echener/velotracker/PU_Website/Bilder/Aaron.PNG

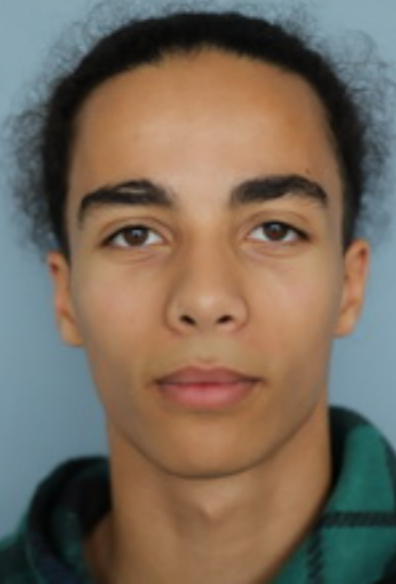
PU_Website/Bilder/Aaron.PNG
