echener/velotracker/PU_Website/Bilder/Francois.PNG

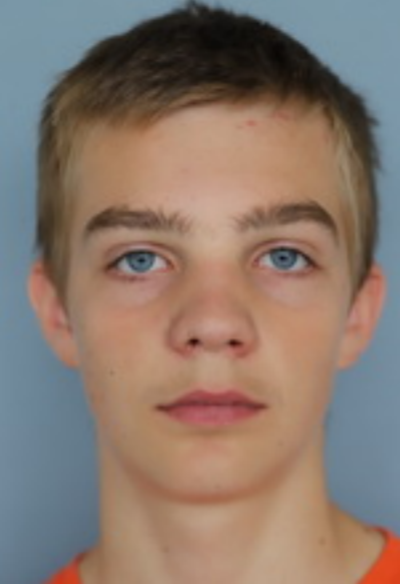
PU_Website/Bilder/Francois.PNG
