echener/velotracker/README.md

# Velotracker
Das Ziel dieses Projektes war ein Tracker für Fahrräder zu bauen. Dieser sollte unauffällig sein und somit als Diebstahlschutz dienen. Das Projekt ist im Rahmen des Projektunterrichts 2021 entstanden.

In diesem Repository befindet sich das Programm für den ESP32, das Schaltbild und den Empfänger auf der Serverseite.
