echener/velotracker/PU_Website/Bilder/Customer_Supp.png

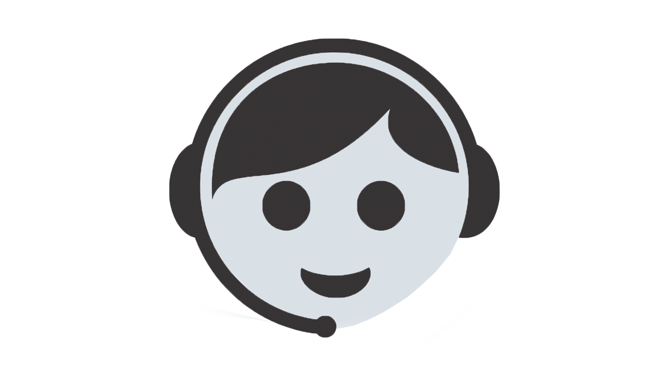
PU_Website/Bilder/Customer_Supp.png
