echener/velotracker/PU_Website/Bilder/Design.png

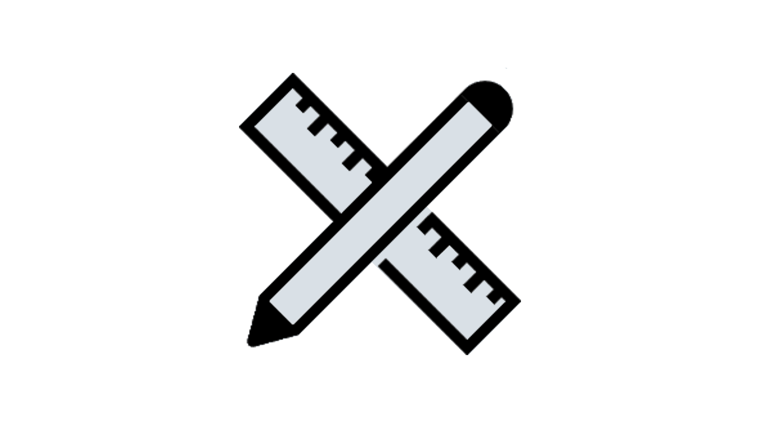
PU_Website/Bilder/Design.png
