echener/velotracker/PU_Website/Bilder/Dokument.png

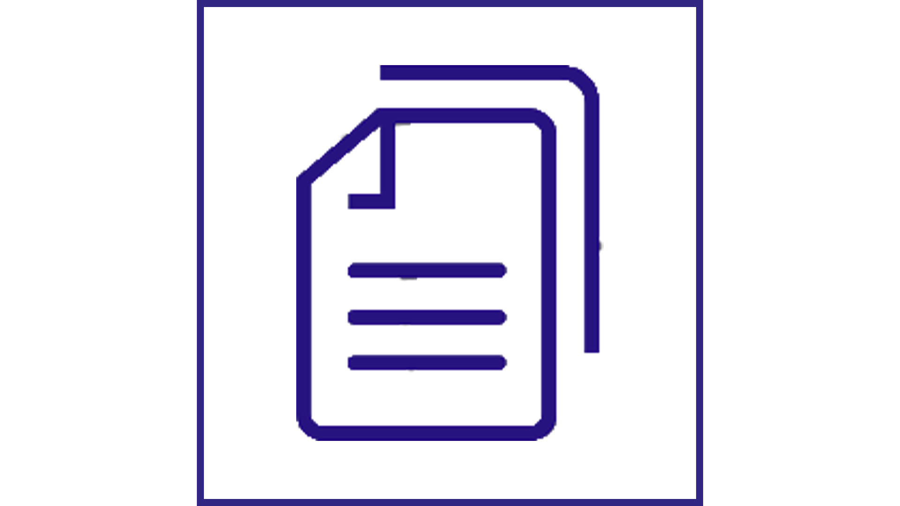
PU_Website/Bilder/Dokument.png
