echener/velotracker/PU_Website/Bilder/Piotr.PNG

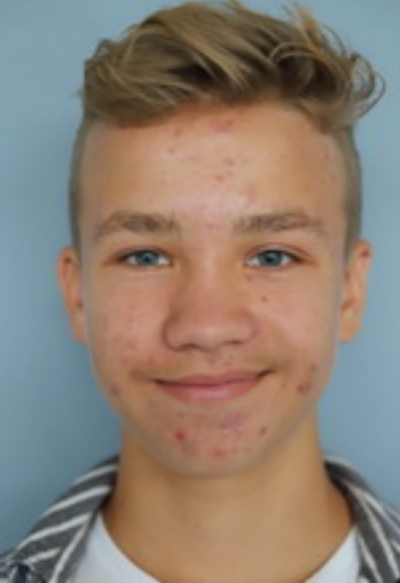
PU_Website/Bilder/Piotr.PNG
