echener/velotracker/PU_Website/Bilder/Safety2.png

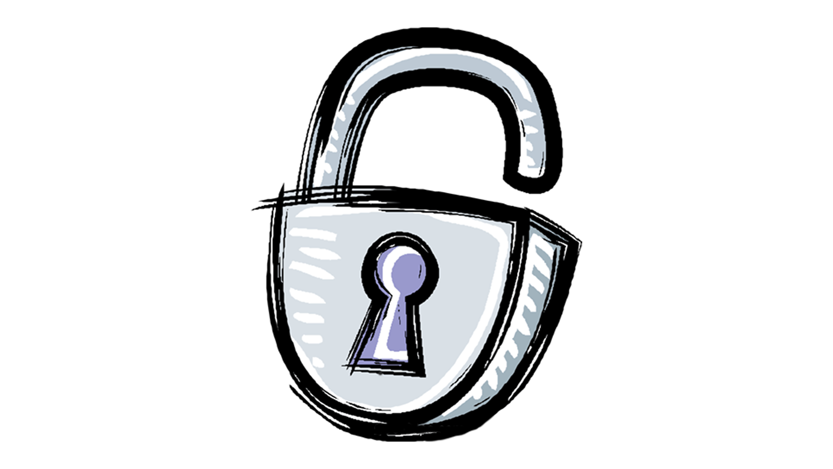
PU_Website/Bilder/Safety2.png
