echener/velotracker/PU_Website/Bilder/Tom.PNG

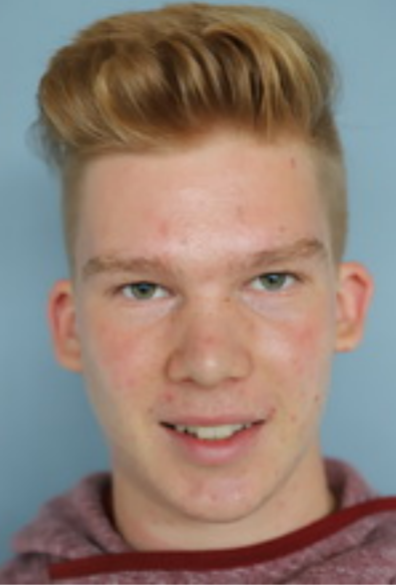
PU_Website/Bilder/Tom.PNG
