echener/velotracker/PU_Website/Bilder/Worldwide.png

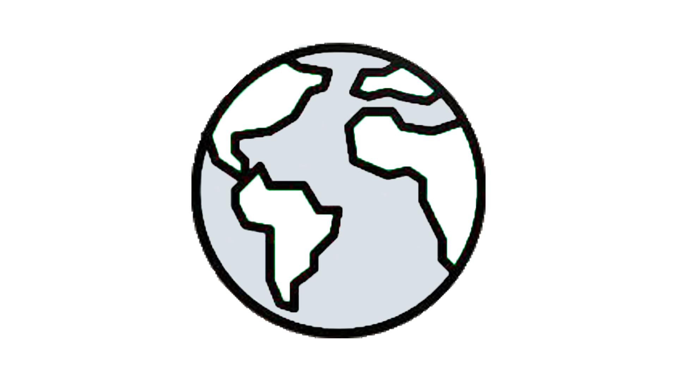
PU_Website/Bilder/Worldwide.png
