echener/velotracker/Anleitung Webseite.docx

Anleitung Webseite

1. Dateien von https://github.com/echener/velotracker/tree/main downloaden
2. Neuen Ordner erstellen
3. Folgende HTML-Dateien im Hauptordner lassen:

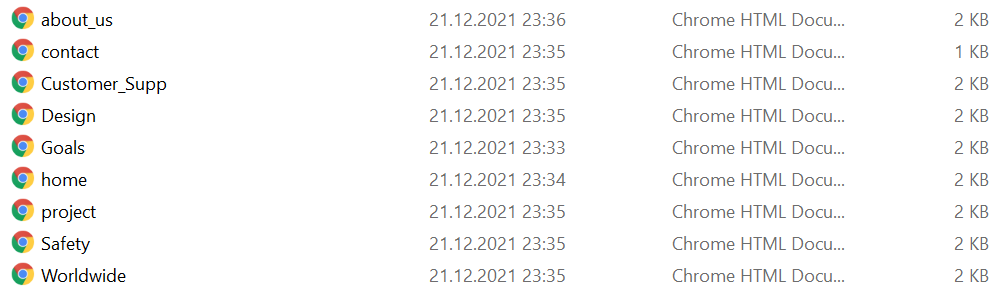
[picture p11: figure]

4. Unterordner mit Namen «Bilder» im Hauptordner erstellen, alle PNG-Dateien hier ablegen.

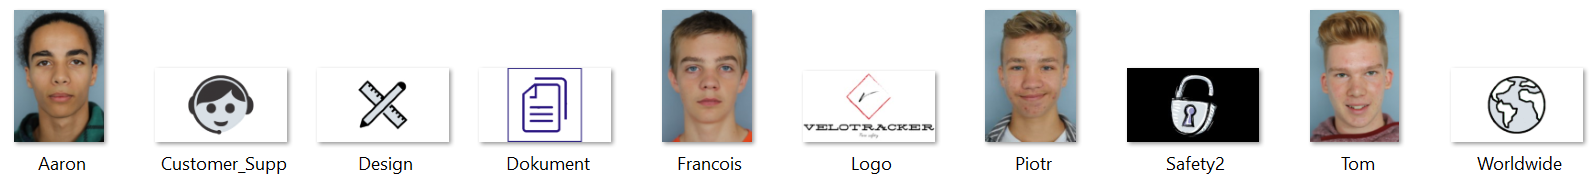
[picture p12: figure]

5. Unterordner mit Namen «Documents» im Hauptordner erstellen, folgende

HTML-Dateien hier ablegen.

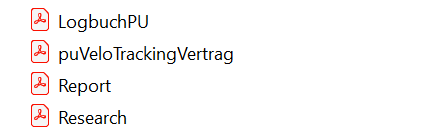
[picture p13: figure]

6. Unterordner mit Namen «Stylesheet» im Hauptordner erstellen, folgende

CSS-Dateien hier ablegen.

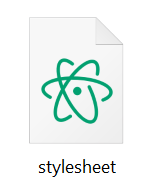
[picture p14: figure]

7. home.HTML mit Google Chrome öffnen.

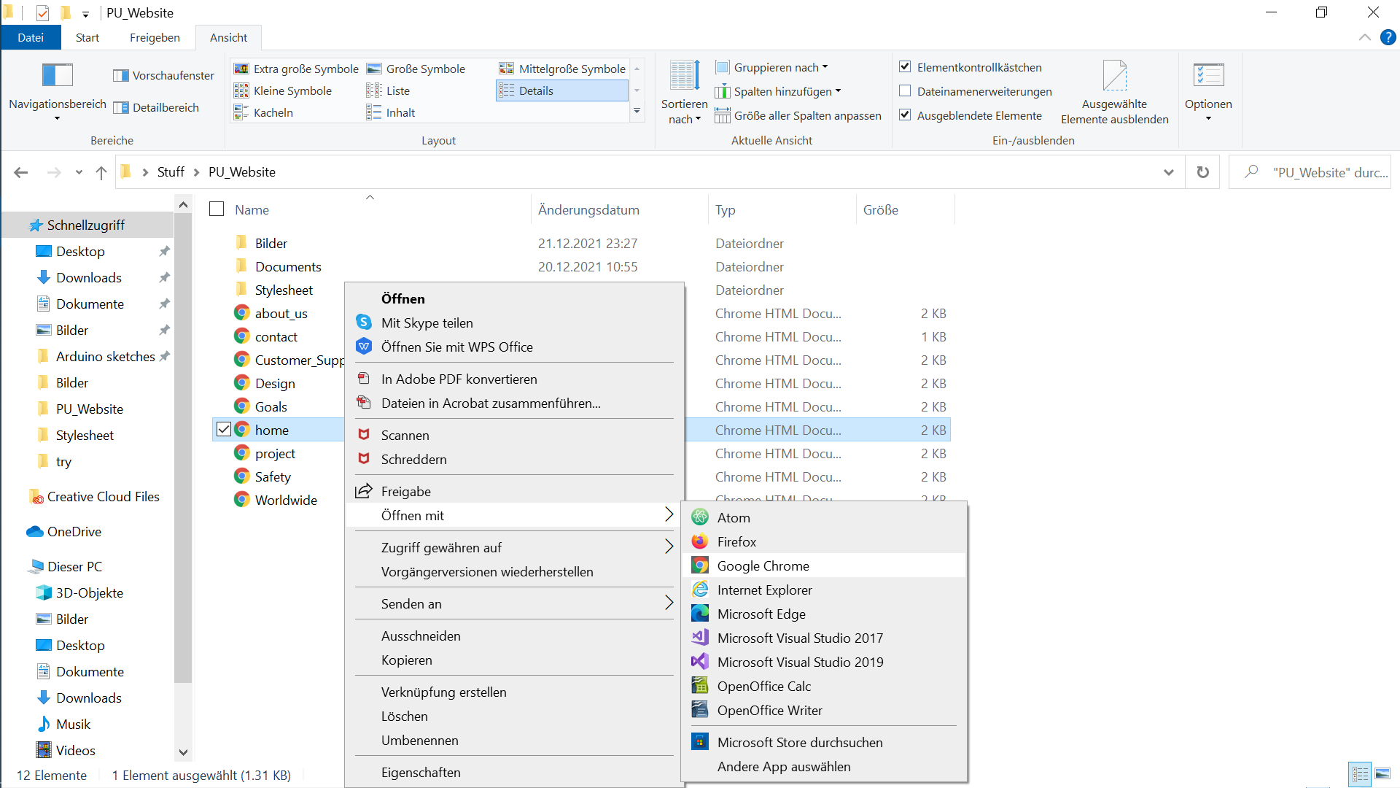
[picture p15: figure]

8. Webseite erkunden!

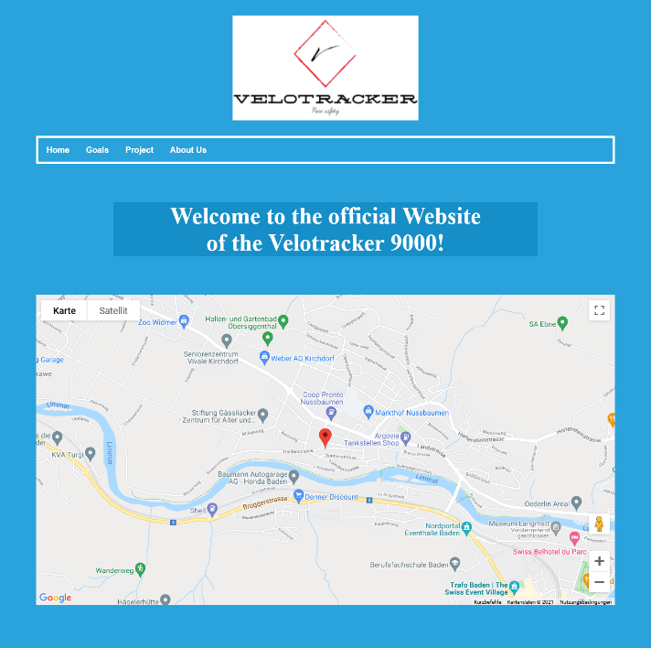
[picture p16: figure]
